sqf-ice/OpenLoWPAN/hardware/dongle_schematic_revA.pdf

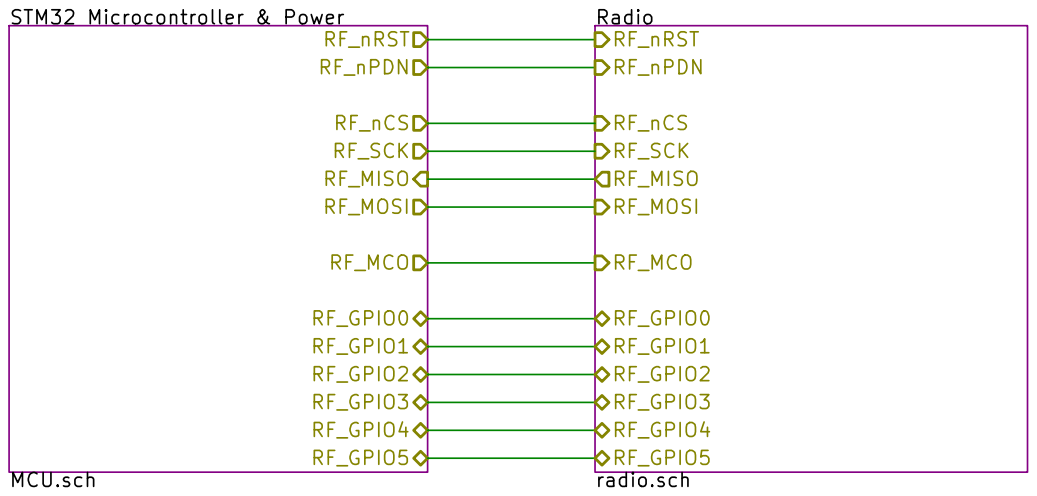
[picture p1: page 1]

File: dongle.sch Sheet: /
Id: 1/3 Title: 6LoWPAN / IEEE 802.15.4 USB dongle

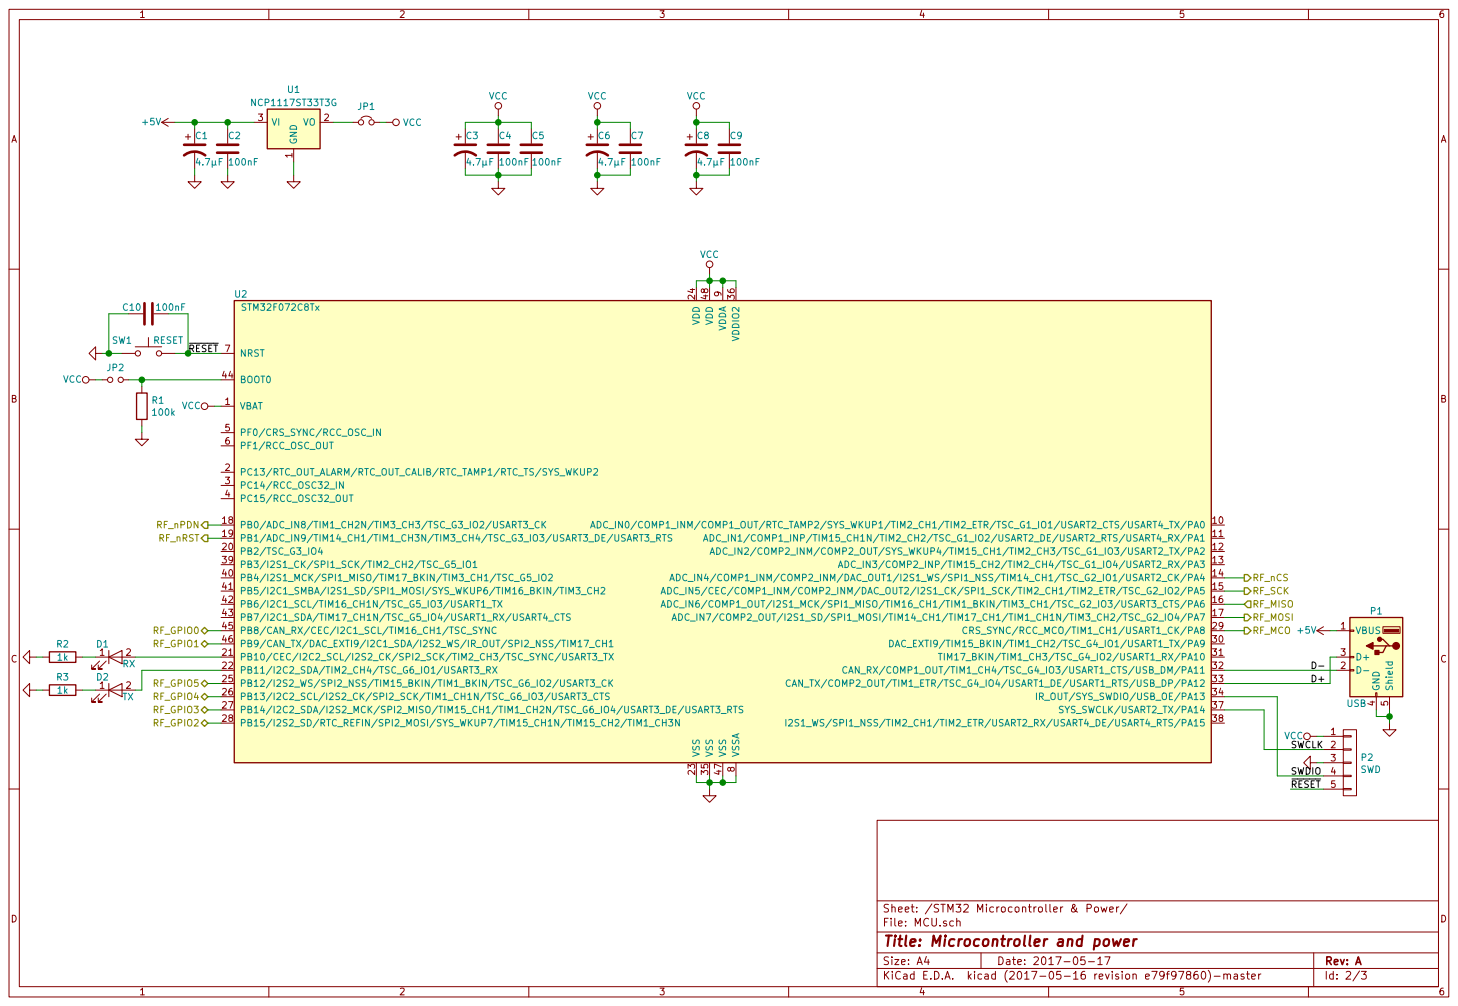
[picture p2: page 2]

Id: 2/3 Title: Microcontroller and power File: MCU.sch Sheet: /STM32 Microcontroller & Power/

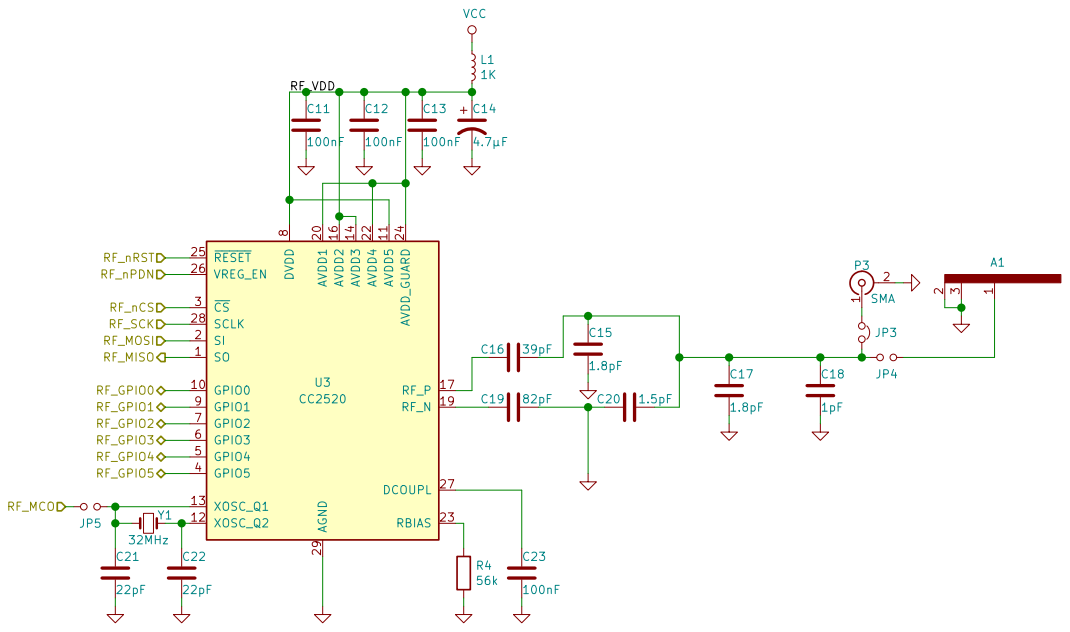
[picture p3: page 3]

8 GPIO1 9 GPIO0 10 AVDD1 20 AVDD5 11 XOSC_Q2 12 AVDD4 22 XOSC_Q1 13 RBIAS 23 AVDD3 14 AVDD_GUARD 24 RESET 25 AVDD2 16 VREG_EN 26 RF_P 17 DCOUPL 27 SCLK 28 RF_N 19 AGND 29 U3 CC2520

Id: 3/3 Title: 2.4 GHz IEEE 802.15.4 Transceiver File: radio.sch Sheet: /Radio/
