sqf-ice/OpenLoWPAN/hardware/dongle.kicad_pcb

## KiCad design hardware/dongle.kicad_pcb (2017-05-17)

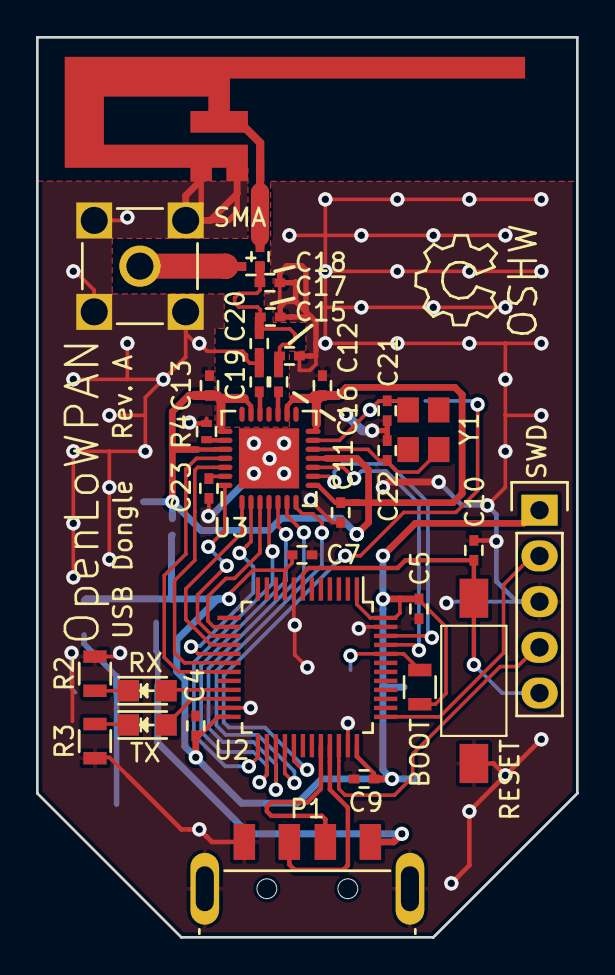
[picture p4: board dongle.kicad_pcb from above]

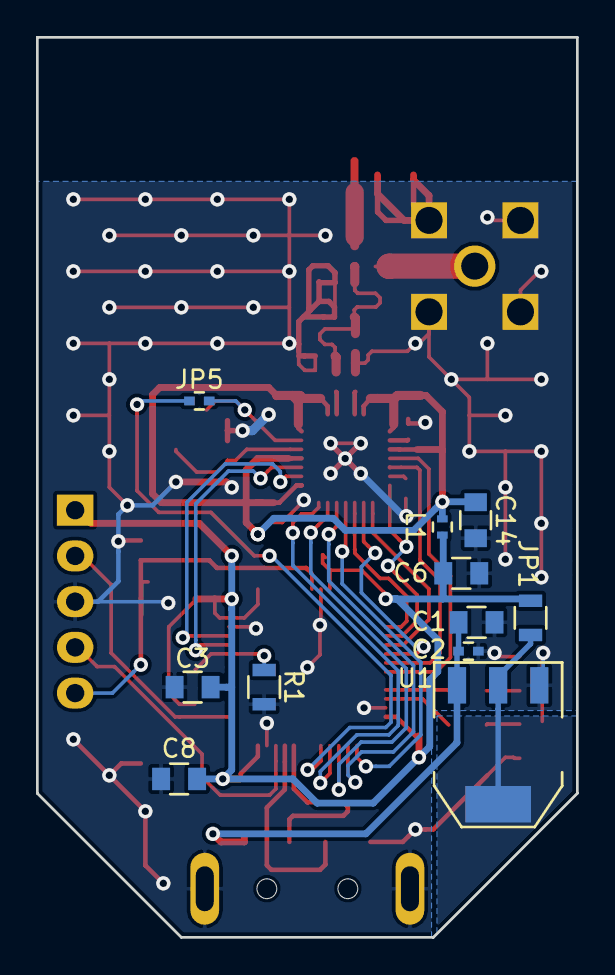
[picture p5: board dongle.kicad_pcb from below]

Board: 2 copper layers, 30.0 x 50.0 mm, 44 parts (11 on the bottom side), 37 nets.

Parts:
A1: INV_F_ANT
C1, C3, C6, C8, C14: 4.7µF; C_0805
C2, C4, C5, C7, C9, C10, C11, C12, C13, C23: 100nF; C_0402
C15, C17: 1.8pF; C_0402
C16: 39pF; C_0402
C18: 1pF; C_0402
C19: 82pF; C_0402
C20: 1.5pF; C_0402
C21, C22: 22pF; C_0402
D1: RX; LED_0805
D2: TX; LED_0805
JP1: Jumper_NC_Small; R_0805
JP2: BOOT; R_0805
JP3: Jumper_NC_Small; C_0402
JP4, JP5: Jumper_NO_Small; C_0402
L1: 1K; R_0402
P1: USB; USBA-M-SM
P2: SWD; Pin_Header_Straight_1x05
P3: SMA
R1: 100k; R_0805
R2, R3: 1k; R_0805
R4: 56k; R_0402
RESET: RESET; SW_SPST_FSMSM
U1: NCP1117ST33T3G; SOT-223
U2: STM32F072C8Tx; LQFP-48_7x7mm_Pitch0.5mm
U3: CC2520; QFN-28-1EP_5x5mm_Pitch0.5mm
Y1: 32MHz; Crystal_3225

Connections:
+5V: C1.1, C2.1, P1.1, U1.3
/Radio/RF_GPIO0: U2.45, U3.10
/Radio/RF_GPIO1: U2.46, U3.9
/Radio/RF_GPIO2: U2.28, U3.7
/Radio/RF_GPIO3: U2.27, U3.6
/Radio/RF_GPIO4: U2.26, U3.5
/Radio/RF_GPIO5: U2.25, U3.4
/Radio/RF_MCO: JP5.1, U2.29
/Radio/RF_MISO: U2.16, U3.1
/Radio/RF_MOSI: U2.17, U3.2
/Radio/RF_SCK: U2.15, U3.28
/Radio/RF_VDD: C11.1, C12.1, C13.1, C14.1, L1.2, U3.8, U3.11, U3.14, U3.16, U3.20, U3.22, U3.24
/Radio/RF_nCS: U2.14, U3.3
/Radio/RF_nPDN: U2.18, U3.26
/Radio/RF_nRST: U2.19, U3.25
/STM32 Microcontroller & Power/D+: P1.3, U2.33
/STM32 Microcontroller & Power/D-: P1.2, U2.32
/STM32 Microcontroller & Power/SWCLK: P2.2, U2.37
/STM32 Microcontroller & Power/SWDIO: P2.4, U2.34
/STM32 Microcontroller & Power/~RESET: C10.1, P2.5, RESET.2, U2.7
GND: A1.2, A1.3, C1.2, C2.2, C3.2, C4.2, C5.2, C6.2, C7.2, C8.2, C9.2, C10.2, C11.2, C12.2, C13.2, C14.2, C15.2, C17.2, C18.2, C19.1, C20.2, C21.2, C22.2, C23.2, P1.4, P1.5, P2.3, P3.2, R1.2, R2.2, R3.2, R4.2, RESET.1, U1.1, U2.8, U2.23, U2.35, U2.47, U3.29
unnamed: A1.1, JP4.2
unnamed: C15.1, C16.1, C17.1, C18.1, C20.1, JP3.2, JP4.1
unnamed: C16.2, U3.17
unnamed: C19.2, U3.19
unnamed: C21.1, JP5.2, U3.13, Y1.1
unnamed: C22.1, U3.12, Y1.2
unnamed: C23.1, U3.27
unnamed: D1.1, R2.1
unnamed: D1.2, U2.21
unnamed: D2.1, R3.1
unnamed: D2.2, U2.22
unnamed: JP1.1, U1.2
unnamed: JP2.2, R1.1, U2.44
unnamed: JP3.1, P3.1
unnamed: R4.1, U3.23
VCC: C3.1, C4.1, C5.1, C6.1, C7.1, C8.1, C9.1, JP1.2, JP2.1, L1.1, P2.1, U2.1, U2.9, U2.24, U2.36, U2.48
