sqf-ice/OpenLoWPAN/dongle/board/board.h

#ifndef _BOARD_H_
#define _BOARD_H_

/*
 * Setup for OpenLoWPAN dongle board board.
 */

/*
 * Board identifier.
 */
#define BOARD_OPENLOWPAN_DONGLE
#define BOARD_NAME                  "OpenLoWPAN dongle board"

/*
 * Board oscillators-related settings.
 * NOTE: LSE not fitted.
 * NOTE: HSE not fitted.
 */
#if !defined(STM32_LSECLK)
#define STM32_LSECLK                0U
#endif

#define STM32_LSEDRV                (0U << 3U)

#if !defined(STM32_HSECLK)
#define STM32_HSECLK                0U
#endif

/*
 * MCU type as defined in the ST header.
 */
#define STM32F072x8

/*
 * IO pins assignments.
 */
#define GPIOA_PIN0                  0U
#define GPIOA_PIN1                  1U
#define GPIOA_PIN2                  2U
#define GPIOA_PIN3                  3U
#define GPIOA_RF_CS                 4U
#define GPIOA_RF_SCK                5U
#define GPIOA_RF_MISO               6U
#define GPIOA_RF_MOSI               7U
#define GPIOA_RF_MCO                8U
#define GPIOA_PIN9                  9U
#define GPIOA_PIN10                 10U
#define GPIOA_USB_DM                11U
#define GPIOA_USB_DP                12U
#define GPIOA_SWDIO                 13U
#define GPIOA_SWCLK                 14U
#define GPIOA_PIN15                 15U

#define GPIOB_RF_PDN                0U
#define GPIOB_RF_RST                1U
#define GPIOB_PIN2                  2U
#define GPIOB_PIN3                  3U
#define GPIOB_PIN4                  4U
#define GPIOB_PIN5                  5U
#define GPIOB_PIN6                  6U
#define GPIOB_PIN7                  7U
#define GPIOB_RF_GPIO0              8U
#define GPIOB_RF_GPIO1              9U
#define GPIOB_LED_RX                10U
#define GPIOB_LED_TX                11U
#define GPIOB_RF_GPIO5              12U
#define GPIOB_RF_GPIO4              13U
#define GPIOB_RF_GPIO3              14U
#define GPIOB_RF_GPIO2              15U

#define GPIOC_PIN0                  0U
#define GPIOC_PIN1                  1U
#define GPIOC_PIN2                  2U
#define GPIOC_PIN3                  3U
#define GPIOC_PIN4                  4U
#define GPIOC_PIN5                  5U
#define GPIOC_PIN6                  6U
#define GPIOC_PIN7                  7U
#define GPIOC_PIN8                  8U
#define GPIOC_PIN9                  9U
#define GPIOC_PIN10                 10U
#define GPIOC_PIN11                 11U
#define GPIOC_PIN12                 12U
#define GPIOC_PIN13                 13U
#define GPIOC_OSC32_IN              14U
#define GPIOC_OSC32_OUT             15U

#define GPIOD_PIN0                  0U
#define GPIOD_PIN1                  1U
#define GPIOD_PIN2                  2U
#define GPIOD_PIN3                  3U
#define GPIOD_PIN4                  4U
#define GPIOD_PIN5                  5U
#define GPIOD_PIN6                  6U
#define GPIOD_PIN7                  7U
#define GPIOD_PIN8                  8U
#define GPIOD_PIN9                  9U
#define GPIOD_PIN10                 10U
#define GPIOD_PIN11                 11U
#define GPIOD_PIN12                 12U
#define GPIOD_PIN13                 13U
#define GPIOD_PIN14                 14U
#define GPIOD_PIN15                 15U

#define GPIOE_PIN0                  0U
#define GPIOE_PIN1                  1U
#define GPIOE_PIN2                  2U
#define GPIOE_PIN3                  3U
#define GPIOE_PIN4                  4U
#define GPIOE_PIN5                  5U
#define GPIOE_PIN6                  6U
#define GPIOE_PIN7                  7U
#define GPIOE_PIN8                  8U
#define GPIOE_PIN9                  9U
#define GPIOE_PIN10                 10U
#define GPIOE_PIN11                 11U
#define GPIOE_PIN12                 12U
#define GPIOE_PIN13                 13U
#define GPIOE_PIN14                 14U
#define GPIOE_PIN15                 15U

#define GPIOF_OSC_IN                0U
#define GPIOF_OSC_OUT               1U
#define GPIOF_PIN2                  2U
#define GPIOF_PIN3                  3U
#define GPIOF_PIN4                  4U
#define GPIOF_PIN5                  5U
#define GPIOF_PIN6                  6U
#define GPIOF_PIN7                  7U
#define GPIOF_PIN8                  8U
#define GPIOF_PIN9                  9U
#define GPIOF_PIN10                 10U
#define GPIOF_PIN11                 11U
#define GPIOF_PIN12                 12U
#define GPIOF_PIN13                 13U
#define GPIOF_PIN14                 14U
#define GPIOF_PIN15                 15U

/*
 * IO lines assignments.
 */
#define GPIO_RF_CS                  PAL_LINE(GPIOA, 4U)
#define GPIO_RF_SCK                 PAL_LINE(GPIOA, 5U)
#define GPIO_RF_MISO                PAL_LINE(GPIOA, 6U)
#define GPIO_RF_MOSI                PAL_LINE(GPIOA, 7U)
#define GPIO_RF_MCO                 PAL_LINE(GPIOA, 8U)
#define GPIO_USB_DM                 PAL_LINE(GPIOA, 11U)
#define GPIO_USB_DP                 PAL_LINE(GPIOA, 12U)
#define GPIO_SWDIO                  PAL_LINE(GPIOA, 13U)
#define GPIO_SWCLK                  PAL_LINE(GPIOA, 14U)

#define GPIO_RF_PDN                 PAL_LINE(GPIOB, 0U)
#define GPIO_RF_RST                 PAL_LINE(GPIOB, 1U)
#define GPIO_RF_GPIO0               PAL_LINE(GPIOB, 8U)
#define GPIO_RF_GPIO1               PAL_LINE(GPIOB, 9U)
#define GPIO_LED_RX                 PAL_LINE(GPIOB, 10U)
#define GPIO_LED_TX                 PAL_LINE(GPIOB, 11U)
#define GPIO_RF_GPIO5               PAL_LINE(GPIOB, 12U)
#define GPIO_RF_GPIO4               PAL_LINE(GPIOB, 13U)
#define GPIO_RF_GPIO3               PAL_LINE(GPIOB, 14U)
#define GPIO_RF_GPIO2               PAL_LINE(GPIOB, 15U)

#define GPIO_OSC32_IN               PAL_LINE(GPIOC, 14U)
#define GPIO_OSC32_OUT              PAL_LINE(GPIOC, 15U)

#define GPIO_OSC_IN                 PAL_LINE(GPIOF, 0U)
#define GPIO_OSC_OUT                PAL_LINE(GPIOF, 1U)

/*
 * I/O ports initial setup, this configuration is established soon after reset
 * in the initialization code.
 * Please refer to the STM32 Reference Manual for details.
 */
#define PIN_MODE_INPUT(n)           (0U << ((n) * 2U))
#define PIN_MODE_OUTPUT(n)          (1U << ((n) * 2U))
#define PIN_MODE_ALTERNATE(n)       (2U << ((n) * 2U))
#define PIN_MODE_ANALOG(n)          (3U << ((n) * 2U))
#define PIN_ODR_LOW(n)              (0U << (n))
#define PIN_ODR_HIGH(n)             (1U << (n))
#define PIN_OTYPE_PUSHPULL(n)       (0U << (n))
#define PIN_OTYPE_OPENDRAIN(n)      (1U << (n))
#define PIN_OSPEED_VERYLOW(n)       (0U << ((n) * 2U))
#define PIN_OSPEED_LOW(n)           (1U << ((n) * 2U))
#define PIN_OSPEED_MEDIUM(n)        (2U << ((n) * 2U))
#define PIN_OSPEED_HIGH(n)          (3U << ((n) * 2U))
#define PIN_PUPDR_FLOATING(n)       (0U << ((n) * 2U))
#define PIN_PUPDR_PULLUP(n)         (1U << ((n) * 2U))
#define PIN_PUPDR_PULLDOWN(n)       (2U << ((n) * 2U))
#define PIN_AFIO_AF(n, v)           ((v) << (((n) % 8U) * 4U))

/*
 * GPIOA setup:
 *
 * PA0  - PIN0                      (input pullup).
 * PA1  - PIN1                      (input pullup).
 * PA2  - PIN2                      (input pullup).
 * PA3  - PIN3                      (input pullup).
 * PA4  - RF_CS                     (output pushpull maximum).
 * PA5  - RF_SCK                    (alternate 0).
 * PA6  - RF_MISO                   (alternate 0).
 * PA7  - RF_MOSI                   (alternate 0).
 * PA8  - RF_MCO                    (input pullup).
 * PA9  - PIN9                      (input pullup).
 * PA10 - PIN10                     (input pullup).
 * PA11 - USB_DM                    (input pullup).
 * PA12 - USB_DP                    (input pullup).
 * PA13 - SWDIO                     (alternate 0).
 * PA14 - SWCLK                     (alternate 0).
 * PA15 - PIN15                     (input pullup).
 */
#define VAL_GPIOA_MODER             (PIN_MODE_INPUT(GPIOA_PIN0) |           \
                                     PIN_MODE_INPUT(GPIOA_PIN1) |           \
                                     PIN_MODE_INPUT(GPIOA_PIN2) |           \
                                     PIN_MODE_INPUT(GPIOA_PIN3) |           \
                                     PIN_MODE_OUTPUT(GPIOA_RF_CS) |         \
                                     PIN_MODE_ALTERNATE(GPIOA_RF_SCK) |     \
                                     PIN_MODE_ALTERNATE(GPIOA_RF_MISO) |    \
                                     PIN_MODE_ALTERNATE(GPIOA_RF_MOSI) |    \
                                     PIN_MODE_INPUT(GPIOA_RF_MCO) |         \
                                     PIN_MODE_INPUT(GPIOA_PIN9) |           \
                                     PIN_MODE_INPUT(GPIOA_PIN10) |          \
                                     PIN_MODE_INPUT(GPIOA_USB_DM) |         \
                                     PIN_MODE_INPUT(GPIOA_USB_DP) |         \
                                     PIN_MODE_ALTERNATE(GPIOA_SWDIO) |      \
                                     PIN_MODE_ALTERNATE(GPIOA_SWCLK) |      \
                                     PIN_MODE_INPUT(GPIOA_PIN15))
#define VAL_GPIOA_OTYPER            (PIN_OTYPE_PUSHPULL(GPIOA_PIN0) |       \
                                     PIN_OTYPE_PUSHPULL(GPIOA_PIN1) |       \
                                     PIN_OTYPE_PUSHPULL(GPIOA_PIN2) |       \
                                     PIN_OTYPE_PUSHPULL(GPIOA_PIN3) |       \
                                     PIN_OTYPE_PUSHPULL(GPIOA_RF_CS) |      \
                                     PIN_OTYPE_PUSHPULL(GPIOA_RF_SCK) |     \
                                     PIN_OTYPE_PUSHPULL(GPIOA_RF_MISO) |    \
                                     PIN_OTYPE_PUSHPULL(GPIOA_RF_MOSI) |    \
                                     PIN_OTYPE_PUSHPULL(GPIOA_RF_MCO) |     \
                                     PIN_OTYPE_PUSHPULL(GPIOA_PIN9) |       \
                                     PIN_OTYPE_PUSHPULL(GPIOA_PIN10) |      \
                                     PIN_OTYPE_PUSHPULL(GPIOA_USB_DM) |     \
                                     PIN_OTYPE_PUSHPULL(GPIOA_USB_DP) |     \
                                     PIN_OTYPE_PUSHPULL(GPIOA_SWDIO) |      \
                                     PIN_OTYPE_PUSHPULL(GPIOA_SWCLK) |      \
                                     PIN_OTYPE_PUSHPULL(GPIOA_PIN15))
#define VAL_GPIOA_OSPEEDR           (PIN_OSPEED_VERYLOW(GPIOA_PIN0) |       \
                                     PIN_OSPEED_VERYLOW(GPIOA_PIN1) |       \
                                     PIN_OSPEED_VERYLOW(GPIOA_PIN2) |       \
                                     PIN_OSPEED_VERYLOW(GPIOA_PIN3) |       \
                                     PIN_OSPEED_HIGH(GPIOA_RF_CS) |         \
                                     PIN_OSPEED_HIGH(GPIOA_RF_SCK) |        \
                                     PIN_OSPEED_HIGH(GPIOA_RF_MISO) |       \
                                     PIN_OSPEED_HIGH(GPIOA_RF_MOSI) |       \
                                     PIN_OSPEED_VERYLOW(GPIOA_RF_MCO) |     \
                                     PIN_OSPEED_VERYLOW(GPIOA_PIN9) |       \
                                     PIN_OSPEED_VERYLOW(GPIOA_PIN10) |      \
                                     PIN_OSPEED_VERYLOW(GPIOA_USB_DM) |     \
                                     PIN_OSPEED_VERYLOW(GPIOA_USB_DP) |     \
                                     PIN_OSPEED_HIGH(GPIOA_SWDIO) |         \
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
                                     PIN_AFIO_AF(GPIOA_SWDIO, 0) |          \
                                     PIN_AFIO_AF(GPIOA_SWCLK, 0) |          \
                                     PIN_AFIO_AF(GPIOA_PIN15, 0))

/*
 * GPIOB setup:
 *
 * PB0  - RF_PDN                    (output pushpull maximum).
 * PB1  - RF_RST                    (output pushpull maximum).
 * PB2  - PIN2                      (input pullup).
 * PB3  - PIN3                      (input pullup).
 * PB4  - PIN4                      (input pullup).
 * PB5  - PIN5                      (input pullup).
 * PB6  - PIN6                      (input pullup).
 * PB7  - PIN7                      (input pullup).
 * PB8  - RF_GPIO0                  (input pullup).
 * PB9  - RF_GPIO1                  (input pullup).
 * PB10 - LED_RX                    (output pushpull maximum).
 * PB11 - LED_TX                    (output pushpull maximum).
 * PB12 - RF_GPIO5                  (input pullup).
 * PB13 - RF_GPIO4                  (input pullup).
 * PB14 - RF_GPIO3                  (input pullup).
 * PB15 - RF_GPIO2                  (input pullup).
 */
#define VAL_GPIOB_MODER             (PIN_MODE_OUTPUT(GPIOB_RF_PDN) |        \
                                     PIN_MODE_OUTPUT(GPIOB_RF_RST) |        \
                                     PIN_MODE_INPUT(GPIOB_PIN2) |           \
                                     PIN_MODE_INPUT(GPIOB_PIN3) |           \
                                     PIN_MODE_INPUT(GPIOB_PIN4) |           \
                                     PIN_MODE_INPUT(GPIOB_PIN5) |           \
                                     PIN_MODE_INPUT(GPIOB_PIN6) |           \
                                     PIN_MODE_INPUT(GPIOB_PIN7) |           \
                                     PIN_MODE_INPUT(GPIOB_RF_GPIO0) |       \
                                     PIN_MODE_INPUT(GPIOB_RF_GPIO1) |       \
                                     PIN_MODE_OUTPUT(GPIOB_LED_RX) |        \
                                     PIN_MODE_OUTPUT(GPIOB_LED_TX) |        \
                                     PIN_MODE_INPUT(GPIOB_RF_GPIO5) |       \
                                     PIN_MODE_INPUT(GPIOB_RF_GPIO4) |       \
                                     PIN_MODE_INPUT(GPIOB_RF_GPIO3) |       \
                                     PIN_MODE_INPUT(GPIOB_RF_GPIO2))
#define VAL_GPIOB_OTYPER            (PIN_OTYPE_PUSHPULL(GPIOB_RF_PDN) |     \
                                     PIN_OTYPE_PUSHPULL(GPIOB_RF_RST) |     \
                                     PIN_OTYPE_PUSHPULL(GPIOB_PIN2) |       \
                                     PIN_OTYPE_PUSHPULL(GPIOB_PIN3) |       \
                                     PIN_OTYPE_PUSHPULL(GPIOB_PIN4) |       \
                                     PIN_OTYPE_PUSHPULL(GPIOB_PIN5) |       \
                                     PIN_OTYPE_PUSHPULL(GPIOB_PIN6) |       \
                                     PIN_OTYPE_PUSHPULL(GPIOB_PIN7) |       \
                                     PIN_OTYPE_PUSHPULL(GPIOB_RF_GPIO0) |   \
                                     PIN_OTYPE_PUSHPULL(GPIOB_RF_GPIO1) |   \
                                     PIN_OTYPE_PUSHPULL(GPIOB_LED_RX) |     \
                                     PIN_OTYPE_PUSHPULL(GPIOB_LED_TX) |     \
                                     PIN_OTYPE_PUSHPULL(GPIOB_RF_GPIO5) |   \
                                     PIN_OTYPE_PUSHPULL(GPIOB_RF_GPIO4) |   \
                                     PIN_OTYPE_PUSHPULL(GPIOB_RF_GPIO3) |   \
                                     PIN_OTYPE_PUSHPULL(GPIOB_RF_GPIO2))
#define VAL_GPIOB_OSPEEDR           (PIN_OSPEED_HIGH(GPIOB_RF_PDN) |        \
                                     PIN_OSPEED_HIGH(GPIOB_RF_RST) |        \
                                     PIN_OSPEED_HIGH(GPIOB_PIN2) |          \
                                     PIN_OSPEED_HIGH(GPIOB_PIN3) |          \
                                     PIN_OSPEED_HIGH(GPIOB_PIN4) |          \
                                     PIN_OSPEED_VERYLOW(GPIOB_PIN5) |       \
                                     PIN_OSPEED_VERYLOW(GPIOB_PIN6) |       \
                                     PIN_OSPEED_VERYLOW(GPIOB_PIN7) |       \
                                     PIN_OSPEED_HIGH(GPIOB_RF_GPIO0) |      \
                                     PIN_OSPEED_HIGH(GPIOB_RF_GPIO1) |      \
                                     PIN_OSPEED_HIGH(GPIOB_LED_RX) |        \
                                     PIN_OSPEED_HIGH(GPIOB_LED_TX) |        \
                                     PIN_OSPEED_HIGH(GPIOB_RF_GPIO5) |      \
                                     PIN_OSPEED_HIGH(GPIOB_RF_GPIO4) |      \
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
                                     PIN_AFIO_AF(GPIOB_RF_GPIO4, 0) |       \
                                     PIN_AFIO_AF(GPIOB_RF_GPIO3, 0) |       \
                                     PIN_AFIO_AF(GPIOB_RF_GPIO2, 0))

/*
 * GPIOC setup:
 *
 * PC0  - PIN0                      (input pullup).
 * PC1  - PIN1                      (input pullup).
 * PC2  - PIN2                      (input pullup).
 * PC3  - PIN3                      (input pullup).
 * PC4  - PIN4                      (input pullup).
 * PC5  - PIN5                      (input pullup).
 * PC6  - PIN6                      (input pullup).
 * PC7  - PIN7                      (input pullup).
 * PC8  - PIN8                      (input pullup).
 * PC9  - PIN9                      (input pullup).
 * PC10 - PIN10                     (input pullup).
 * PC11 - PIN11                     (input pullup).
 * PC12 - PIN12                     (input pullup).
 * PC13 - PIN13                     (input pullup).
 * PC14 - OSC32_IN                  (input floating).
 * PC15 - OSC32_OUT                 (input floating).
 */
#define VAL_GPIOC_MODER             (PIN_MODE_INPUT(GPIOC_PIN0) |           \
                                     PIN_MODE_INPUT(GPIOC_PIN1) |           \
                                     PIN_MODE_INPUT(GPIOC_PIN2) |           \
                                     PIN_MODE_INPUT(GPIOC_PIN3) |           \
                                     PIN_MODE_INPUT(GPIOC_PIN4) |           \
                                     PIN_MODE_INPUT(GPIOC_PIN5) |           \
                                     PIN_MODE_INPUT(GPIOC_PIN6) |           \
                                     PIN_MODE_INPUT(GPIOC_PIN7) |           \
                                     PIN_MODE_INPUT(GPIOC_PIN8) |           \
                                     PIN_MODE_INPUT(GPIOC_PIN9) |           \
                                     PIN_MODE_INPUT(GPIOC_PIN10) |          \
                                     PIN_MODE_INPUT(GPIOC_PIN11) |          \
                                     PIN_MODE_INPUT(GPIOC_PIN12) |          \
                                     PIN_MODE_INPUT(GPIOC_PIN13) |          \
                                     PIN_MODE_INPUT(GPIOC_OSC32_IN) |       \
                                     PIN_MODE_INPUT(GPIOC_OSC32_OUT))
#define VAL_GPIOC_OTYPER            (PIN_OTYPE_PUSHPULL(GPIOC_PIN0) |       \
                                     PIN_OTYPE_PUSHPULL(GPIOC_PIN1) |       \
                                     PIN_OTYPE_PUSHPULL(GPIOC_PIN2) |       \
                                     PIN_OTYPE_PUSHPULL(GPIOC_PIN3) |       \
                                     PIN_OTYPE_PUSHPULL(GPIOC_PIN4) |       \
                                     PIN_OTYPE_PUSHPULL(GPIOC_PIN5) |       \
                                     PIN_OTYPE_PUSHPULL(GPIOC_PIN6) |       \
                                     PIN_OTYPE_PUSHPULL(GPIOC_PIN7) |       \
                                     PIN_OTYPE_PUSHPULL(GPIOC_PIN8) |       \
                                     PIN_OTYPE_PUSHPULL(GPIOC_PIN9) |       \
                                     PIN_OTYPE_PUSHPULL(GPIOC_PIN10) |      \
                                     PIN_OTYPE_PUSHPULL(GPIOC_PIN11) |      \
                                     PIN_OTYPE_PUSHPULL(GPIOC_PIN12) |      \
                                     PIN_OTYPE_PUSHPULL(GPIOC_PIN13) |      \
                                     PIN_OTYPE_PUSHPULL(GPIOC_OSC32_IN) |   \
                                     PIN_OTYPE_PUSHPULL(GPIOC_OSC32_OUT))
#define VAL_GPIOC_OSPEEDR           (PIN_OSPEED_VERYLOW(GPIOC_PIN0) |       \
                                     PIN_OSPEED_VERYLOW(GPIOC_PIN1) |       \
                                     PIN_OSPEED_VERYLOW(GPIOC_PIN2) |       \
                                     PIN_OSPEED_VERYLOW(GPIOC_PIN3) |       \
                                     PIN_OSPEED_VERYLOW(GPIOC_PIN4) |       \
                                     PIN_OSPEED_VERYLOW(GPIOC_PIN5) |       \
                                     PIN_OSPEED_VERYLOW(GPIOC_PIN6) |       \
                                     PIN_OSPEED_VERYLOW(GPIOC_PIN7) |       \
                                     PIN_OSPEED_VERYLOW(GPIOC_PIN8) |       \
                                     PIN_OSPEED_VERYLOW(GPIOC_PIN9) |       \
                                     PIN_OSPEED_VERYLOW(GPIOC_PIN10) |      \
                                     PIN_OSPEED_VERYLOW(GPIOC_PIN11) |      \
                                     PIN_OSPEED_VERYLOW(GPIOC_PIN12) |      \
                                     PIN_OSPEED_VERYLOW(GPIOC_PIN13) |      \
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
                                     PIN_AFIO_AF(GPIOE_PIN13, 0) |          \
                                     PIN_AFIO_AF(GPIOE_PIN14, 0) |          \
                                     PIN_AFIO_AF(GPIOE_PIN15, 0))

/*
 * GPIOF setup:
 *
 * PF0  - OSC_IN                    (input floating).
 * PF1  - OSC_OUT                   (input floating).
 * PF2  - PIN2                      (input pullup).
 * PF3  - PIN3                      (input pullup).
 * PF4  - PIN4                      (input pullup).
 * PF5  - PIN5                      (input pullup).
 * PF6  - PIN6                      (input pullup).
 * PF7  - PIN7                      (input pullup).
 * PF8  - PIN8                      (input pullup).
 * PF9  - PIN9                      (input pullup).
 * PF10 - PIN10                     (input pullup).
 * PF11 - PIN11                     (input pullup).
 * PF12 - PIN12                     (input pullup).
 * PF13 - PIN13                     (input pullup).
 * PF14 - PIN14                     (input pullup).
 * PF15 - PIN15                     (input pullup).
 */
#define VAL_GPIOF_MODER             (PIN_MODE_INPUT(GPIOF_OSC_IN) |         \
                                     PIN_MODE_INPUT(GPIOF_OSC_OUT) |        \
                                     PIN_MODE_INPUT(GPIOF_PIN2) |           \
                                     PIN_MODE_INPUT(GPIOF_PIN3) |           \
                                     PIN_MODE_INPUT(GPIOF_PIN4) |           \
                                     PIN_MODE_INPUT(GPIOF_PIN5) |           \
                                     PIN_MODE_INPUT(GPIOF_PIN6) |           \
                                     PIN_MODE_INPUT(GPIOF_PIN7) |           \
                                     PIN_MODE_INPUT(GPIOF_PIN8) |           \
                                     PIN_MODE_INPUT(GPIOF_PIN9) |           \
                                     PIN_MODE_INPUT(GPIOF_PIN10) |          \
                                     PIN_MODE_INPUT(GPIOF_PIN11) |          \
                                     PIN_MODE_INPUT(GPIOF_PIN12) |          \
                                     PIN_MODE_INPUT(GPIOF_PIN13) |          \
                                     PIN_MODE_INPUT(GPIOF_PIN14) |          \
                                     PIN_MODE_INPUT(GPIOF_PIN15))
#define VAL_GPIOF_OTYPER            (PIN_OTYPE_PUSHPULL(GPIOF_OSC_IN) |     \
                                     PIN_OTYPE_PUSHPULL(GPIOF_OSC_OUT) |    \
                                     PIN_OTYPE_PUSHPULL(GPIOF_PIN2) |       \
                                     PIN_OTYPE_PUSHPULL(GPIOF_PIN3) |       \
                                     PIN_OTYPE_PUSHPULL(GPIOF_PIN4) |       \
                                     PIN_OTYPE_PUSHPULL(GPIOF_PIN5) |       \
                                     PIN_OTYPE_PUSHPULL(GPIOF_PIN6) |       \
                                     PIN_OTYPE_PUSHPULL(GPIOF_PIN7) |       \
                                     PIN_OTYPE_PUSHPULL(GPIOF_PIN8) |       \
                                     PIN_OTYPE_PUSHPULL(GPIOF_PIN9) |       \
                                     PIN_OTYPE_PUSHPULL(GPIOF_PIN10) |      \
                                     PIN_OTYPE_PUSHPULL(GPIOF_PIN11) |      \
                                     PIN_OTYPE_PUSHPULL(GPIOF_PIN12) |      \
                                     PIN_OTYPE_PUSHPULL(GPIOF_PIN13) |      \
                                     PIN_OTYPE_PUSHPULL(GPIOF_PIN14) |      \
                                     PIN_OTYPE_PUSHPULL(GPIOF_PIN15))
#define VAL_GPIOF_OSPEEDR           (PIN_OSPEED_VERYLOW(GPIOF_OSC_IN) |     \
                                     PIN_OSPEED_VERYLOW(GPIOF_OSC_OUT) |    \
                                     PIN_OSPEED_VERYLOW(GPIOF_PIN2) |       \
                                     PIN_OSPEED_VERYLOW(GPIOF_PIN3) |       \
                                     PIN_OSPEED_VERYLOW(GPIOF_PIN4) |       \
                                     PIN_OSPEED_VERYLOW(GPIOF_PIN5) |       \
                                     PIN_OSPEED_VERYLOW(GPIOF_PIN6) |       \
                                     PIN_OSPEED_VERYLOW(GPIOF_PIN7) |       \
                                     PIN_OSPEED_VERYLOW(GPIOF_PIN8) |       \
                                     PIN_OSPEED_VERYLOW(GPIOF_PIN9) |       \
                                     PIN_OSPEED_VERYLOW(GPIOF_PIN10) |      \
                                     PIN_OSPEED_VERYLOW(GPIOF_PIN11) |      \
                                     PIN_OSPEED_VERYLOW(GPIOF_PIN12) |      \
                                     PIN_OSPEED_VERYLOW(GPIOF_PIN13) |      \
                                     PIN_OSPEED_VERYLOW(GPIOF_PIN14) |      \
                                     PIN_OSPEED_VERYLOW(GPIOF_PIN15))
#define VAL_GPIOF_PUPDR             (PIN_PUPDR_FLOATING(GPIOF_OSC_IN) |     \
                                     PIN_PUPDR_FLOATING(GPIOF_OSC_OUT) |    \
                                     PIN_PUPDR_PULLUP(GPIOF_PIN2) |         \
                                     PIN_PUPDR_PULLUP(GPIOF_PIN3) |         \
                                     PIN_PUPDR_PULLUP(GPIOF_PIN4) |         \
                                     PIN_PUPDR_PULLUP(GPIOF_PIN5) |         \
                                     PIN_PUPDR_PULLUP(GPIOF_PIN6) |         \
                                     PIN_PUPDR_PULLUP(GPIOF_PIN7) |         \
                                     PIN_PUPDR_PULLUP(GPIOF_PIN8) |         \
                                     PIN_PUPDR_PULLUP(GPIOF_PIN9) |         \
                                     PIN_PUPDR_PULLUP(GPIOF_PIN10) |        \
                                     PIN_PUPDR_PULLUP(GPIOF_PIN11) |        \
                                     PIN_PUPDR_PULLUP(GPIOF_PIN12) |        \
                                     PIN_PUPDR_PULLUP(GPIOF_PIN13) |        \
                                     PIN_PUPDR_PULLUP(GPIOF_PIN14) |        \
                                     PIN_PUPDR_PULLUP(GPIOF_PIN15))
#define VAL_GPIOF_ODR               (PIN_ODR_HIGH(GPIOF_OSC_IN) |           \
                                     PIN_ODR_HIGH(GPIOF_OSC_OUT) |          \
                                     PIN_ODR_HIGH(GPIOF_PIN2) |             \
                                     PIN_ODR_HIGH(GPIOF_PIN3) |             \
                                     PIN_ODR_HIGH(GPIOF_PIN4) |             \
                                     PIN_ODR_HIGH(GPIOF_PIN5) |             \
                                     PIN_ODR_HIGH(GPIOF_PIN6) |             \
                                     PIN_ODR_HIGH(GPIOF_PIN7) |             \
                                     PIN_ODR_HIGH(GPIOF_PIN8) |             \
                                     PIN_ODR_HIGH(GPIOF_PIN9) |             \
                                     PIN_ODR_HIGH(GPIOF_PIN10) |            \
                                     PIN_ODR_HIGH(GPIOF_PIN11) |            \
                                     PIN_ODR_HIGH(GPIOF_PIN12) |            \
                                     PIN_ODR_HIGH(GPIOF_PIN13) |            \
                                     PIN_ODR_HIGH(GPIOF_PIN14) |            \
                                     PIN_ODR_HIGH(GPIOF_PIN15))
#define VAL_GPIOF_AFRL              (PIN_AFIO_AF(GPIOF_OSC_IN, 0) |         \
                                     PIN_AFIO_AF(GPIOF_OSC_OUT, 0) |        \
                                     PIN_AFIO_AF(GPIOF_PIN2, 0) |           \
                                     PIN_AFIO_AF(GPIOF_PIN3, 0) |           \
                                     PIN_AFIO_AF(GPIOF_PIN4, 0) |           \
                                     PIN_AFIO_AF(GPIOF_PIN5, 0) |           \
                                     PIN_AFIO_AF(GPIOF_PIN6, 0) |           \
                                     PIN_AFIO_AF(GPIOF_PIN7, 0))
#define VAL_GPIOF_AFRH              (PIN_AFIO_AF(GPIOF_PIN8, 0) |           \
                                     PIN_AFIO_AF(GPIOF_PIN9, 0) |           \
                                     PIN_AFIO_AF(GPIOF_PIN10, 0) |          \
                                     PIN_AFIO_AF(GPIOF_PIN11, 0) |          \
                                     PIN_AFIO_AF(GPIOF_PIN12, 0) |          \
                                     PIN_AFIO_AF(GPIOF_PIN13, 0) |          \
                                     PIN_AFIO_AF(GPIOF_PIN14, 0) |          \
                                     PIN_AFIO_AF(GPIOF_PIN15, 0))


#if !defined(_FROM_ASM_)
#ifdef __cplusplus
extern "C" {
#endif
  void boardInit(void);
#ifdef __cplusplus
}
#endif
#endif /* _FROM_ASM_ */

#endif /* _BOARD_H_ */
