sqf-ice/OpenLoWPAN/(commit log)

2016-08-07 Initial commit: USB dongle schematic & PCB.
    [MCU.sch, dongle.kicad_pcb, dongle.sch, dongle_BOM.csv, radio.sch]
2016-08-09 Final version of PCB, Gerber files.
    [dongle.kicad_pcb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]
2017-05-17 Fix USB connector flipped.
    Update schematic to new kicad.
    [MCU.sch, dongle.kicad_pcb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]
2017-05-18 Preparation for software.
    [MCU.sch, dongle.kicad_pcb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]
2017-05-29 Reference PCB for usage in other projects.
    [cc2520_reference.kicad_pcb]
2017-07-21 Very first version of 802.14.5 sniffer.
    Use stm32-cmake as submodule.
2017-07-25 Fix 802.15.4 -> 802.14.5 typo.
    [cc2520.c, cc2520.h, mac802.15.4.c, mac802.15.4.h, main.c]
